XenoCube/ForeignBox/BOM.xlsx

Hardware
Quantity | Part | Description | Price | Link to Purchase
 | Exstrusion bar 20mm x 20mm | 15.99 for 6 ft | 32 | https://www.amazon.com/PDTech-T-slot-frame-aluminum-extrusion/dp/B071HBRBG8?s=industrial
2 | 8mm Lead Rod x 500mm x 2mm pitch W/ screw |  | 18.99 | https://www.amazon.com/GOCHANGE-Printer-Accessories-Stainless-Coupling/dp/B01GL4GYSK?s=industrial
1 | 8mm Lead Rod x 400mm x 2mm pitch W/ screw | 12.59 per one | 12.59 | https://www.amazon.com/Drillpro-400mm-Lead-Screw-Printer/dp/B017AR5QBS?s=industrial
8 | 8mm Drill Rod | 2 pack of 400mm length rods 18.50 per a pack. 4 rods will need to be 500mm for Z axis. | 80 | https://www.amazon.com/2-Pack-Linear-Motion-Length-Hardened/dp/B01I49ESN8?s=industrial
2 | M3 Socket Head Screw 20mm | 14.99 pack | 30 | https://www.amazon.com/Hilitchi-210pcs-Stainless-Socket-Assortment/dp/B014ONCP88?s=industrial
* | M3 Socket Head Screw 12mm | * | *
* | M3 Socket Head Screw | * | *
* | M3 Socket Head Screw | * | *
* | M3 Nut | * | *
100 | M5 Pan Socket Head Screw 10mm | 8.36 a pack | 17.24 | https://www.amazon.com/uxcell-Alloy-Socket-Button-Screws/dp/B019ETJWEC?s=industrial
100 | M5 Pan Socket Head Screw 8mm | 8.18 a pack of 50mm | 16.36 | https://www.amazon.com/uxcell-Alloy-Socket-Button-Screws/dp/B019ETJRME?s=industrial
3 | 608zz Bearings | 7.47 a pack of 8 | 7.47 | https://www.amazon.com/Skateboard-Bearings-Double-Shielded-Silver/dp/B002BBGTK6?s=industrial
1 | E3D V6 Hotend bowden 1.75mm | E3d V6 1.75mm Universal | 70.21 | https://www.amazon.com/E3D-All-metal-HotEnd-Full-Kit/dp/B00NAK9JFO?s=industrial
3 | Z Axis Couplers | 8.97 for a pack of 2 | 16 | https://www.amazon.com/3D-CAM-Flexible-Couplings-Printer/dp/B010MZ8T2S?s=industrial
1 | MK8 Extruder |  | 19.98 | https://www.amazon.com/Witbot-Printer-Extruder-Aluminum-Reprap/dp/B01KO42SBA?s=industrial
200 | M5 T Nut | This is the nut that works with the Exstrusion Bar. 18.99 for a pack of 100 | 37.98 | https://www.amazon.com/Economy-Pre-Assembly-T-Slot-Aluminum-Extrusions/dp/B018X8IRGY?s=industrial
15 | LM8UU Linear Bearings | 7.65 for 10 pack | 15 | https://www.amazon.com/uxcell-Bushing-Linear-Motion-Double/dp/B00X9H22SO
1 | Kapton Tape Sheet | 300mm x 300mm
5 | Plexiglass Sheet 18 in. x 24 in. x .080 in. (2mm)
1 | 3mm Foam Sheet
Electronics
Quantity | Part | Description | Price | Link to Purchase
6 | Nema Stepper Motors | Nema 17 Stepper Motors | 84 | https://www.amazon.com/Stepper-Bipolar-4-lead-Connector-Printer/dp/B00PNEQKC0
1 | MKS printer board | Osoyoo MKS Base V1.5 | 38.9 | https://www.amazon.com/OSOYOO-Controller-Combination-MEGA2560-RAMPS1-4/dp/B015SKY19M
1 | Raspberry Pi | Raspberry Pi 3 | 38.61 | https://www.amazon.com/Raspberry-Model-A1-2GHz-64-bit-quad-core/dp/B01CD5VC92?s=pc
1 | Mosfet Heatbed controller |  | 18 | https://www.reprap.me/electronics/power-expander.html
1 | 24v Power Supply | 24v x 600w Regulated Power Supply | 56.5 | https://www.amazon.com/Eyeboot-Universal-Regulated-Switching-Computer/dp/B018TH0DQG?s=electronics
1 | AC Plug W/ Switch W/ 10 amp Fuse | Power Cord connection w/ fuse /switch | 5.98 | https://www.amazon.com/URBEST-Module-Switch-Certification-Socket/dp/B00ME5YAPK?s=electronics
1 | 24v to 12v Power Inverter | 24v to 12v Power Inverter | 19.98 | https://www.amazon.com/Nextrox-Converter-Regulator-Step-Down/dp/B00BWKXTUU
2 | 8 Terminal Barrier Block | **4 terinmal block with insulated barrier strip | 10.8 | https://www.amazon.com/Position-Terminal-Postions-Insulated-Barrier/dp/B01AQ94ERY?s=electronics
1 | 12v to 5v Power Inverter | 12v to 5v | 6.99 | https://www.amazon.com/SMAKN-Converter-Power-Supply-Module/dp/B00CXKBJI2?s=electronics
4 | Optic Endstop Sensors | Optical EndStops | 8.99 | https://www.amazon.com/BIQU-Optical-Endstop-Control-Printer/dp/B01FLSA47O?s=industrial
2 | 40mm x 40mm x 10mm Fan 12v | 40mm Case Fan | 15.68 | https://www.amazon.com/2packs-0-15A-Brushless-Cooling-AB4010M12/dp/B01CZFUOD0?s=industrial
1 | Inductive Sensor | 4mm inductive sensor for bed leveling | 7.89 | https://www.amazon.com/uxcell-DC6-36V-Inductive-Proximity-LJ12A3-4-Z-BX/dp/B008DG9FLS?s=industrial
1 | 300mm x 300mm MKS Heatbed | 300mm heatbed | 30.99 | https://www.amazon.com/TriGorilla-Printer-Aluminum-Heatbed-Supply/dp/B01KJJYIPE?s=industrial
1 | Thermistor | Only one is needed but pack of three listed | 7.5 | https://www.amazon.com/3D-CAM-Thermistors-pre-wired-Insulated/dp/B010MZ8TCS?s=industrial
 | 14 gauge Wire Red | pack of red and black | 21.95 | https://www.amazon.com/ENNIS-ELECTRONICS-PRIMARY-REMOTE-COPPER/dp/B06XCTWPMM?s=industrial
 | 14 gauge Wire Black | * | * | *
 | 12 guage Wire Black | Pack of red and black | 13.97 | https://www.amazon.com/GAUGE-GROUND-PRIMARY-STRANDED-COPPER/dp/B01AO1K5HW?s=industrial
 | 12 gauge Wire Red | * | * | *
 | 18 gauge Wire Red | Single Spool | 8.98 | https://www.amazon.com/Southwire-55667423-Primary-18-Gauge-100-Feet/dp/B000HACYOS?s=industrial
 | 18 gauge Wire Black | Single spool |  | https://www.amazon.com/Southwire-55667423-Primary-18-Gauge-100-Feet/dp/B000HACYOS?s=industrial
 | Heat Shrink | Assorted | 6.95 | https://www.amazon.com/Anytime-Tools-AT201262-Shrink-Assorted/dp/B008WWC6FU?s=industrial
 | 12-10 gauge Quick Disconnects | Assorted | 15.99 | https://www.amazon.com/Glarks-Disconnect-Electrical-Connectors-Assortment/dp/B01E3TGECG?s=industrial
 | 14-16 gauge Spade or Ring Wire Connectors | *
 | 2x40 Pin 2,54 Pitch - Header Pins
 |  |  | 792.47
