XenoCube/ForeignBox/(list of files, cad)

Other CAD files:
XC Sketchup/12to5v Inverter and Heatbed Relay Mount.skp
XC Sketchup/24vTo12 Inverter Mount.skp
XC Sketchup/8mm Threaded Rod Stay.skp
XC Sketchup/90 Wire Clamp.skp
XC Sketchup/Cam Mount.skp
XC Sketchup/Door Handle.skp
XC Sketchup/Door Hinge.skp
XC Sketchup/Filament Spool Holder.skp
XC Sketchup/Frame Corner Foot Bracket.skp
XC Sketchup/Frame T Bracket.skp
XC Sketchup/Heatbead Wire Holder.skp
XC Sketchup/Heatbed Plate Mount.skp
XC Sketchup/HotEnd Ducting.skp
XC Sketchup/Hotend Ducting Back.skp
XC Sketchup/Hotend Ducting Fan Mount.skp
XC Sketchup/Hotend Ducting Upper.skp
XC Sketchup/LED Light Clamp.skp
XC Sketchup/MKS Controller Board Mount Leftside.skp
XC Sketchup/MKS Controller Board Mount Rightside.skp
XC Sketchup/Power Supply Mount Left.skp
XC Sketchup/Power Supply Mount Right.skp
XC Sketchup/Power Switch Mount.skp
XC Sketchup/Raspberry Pi Mount.skp
XC Sketchup/Tension Spring Cap Extruder.skp
XC Sketchup/Terminal Block Bracket.skp
XC Sketchup/Top Corner Cover Plate.skp
XC Sketchup/Top Middle Cover Plate.skp
XC Sketchup/Top Slider Corner with Wiring.skp
XC Sketchup/Wire Clamp 6mm Hole Ziptie.skp
XC Sketchup/Wire Clamp 90 Outside.skp
XC Sketchup/X Axis Carriage.skp
XC Sketchup/X Axis Endstop.skp
XC Sketchup/X Axis Idler V5.skp
XC Sketchup/X Axis Motor Mount v3.skp
XC Sketchup/XY Endstop v3.skp
XC Sketchup/Y Axis End Stop.skp
XC Sketchup/Y Axis Motor Mount v2.skp
XC Sketchup/Y Axis Motor Mount.skp
XC Sketchup/Y Axis Smooth Rod Bracket.skp
XC Sketchup/Y Axis Wire Holder.skp
XC Sketchup/Z Axis Bed Mount.skp
XC Sketchup/Z Axis Endstop Adjustable Inductive Bed Level.skp
XC Sketchup/Z Axis Motor Mount.skp
XC Sketchup/Z Endstop.skp
XC Sketchup/Z-Axis idler v5.skp
