XenoCube/ForeignBox/Power Wiring Diagram.jpg

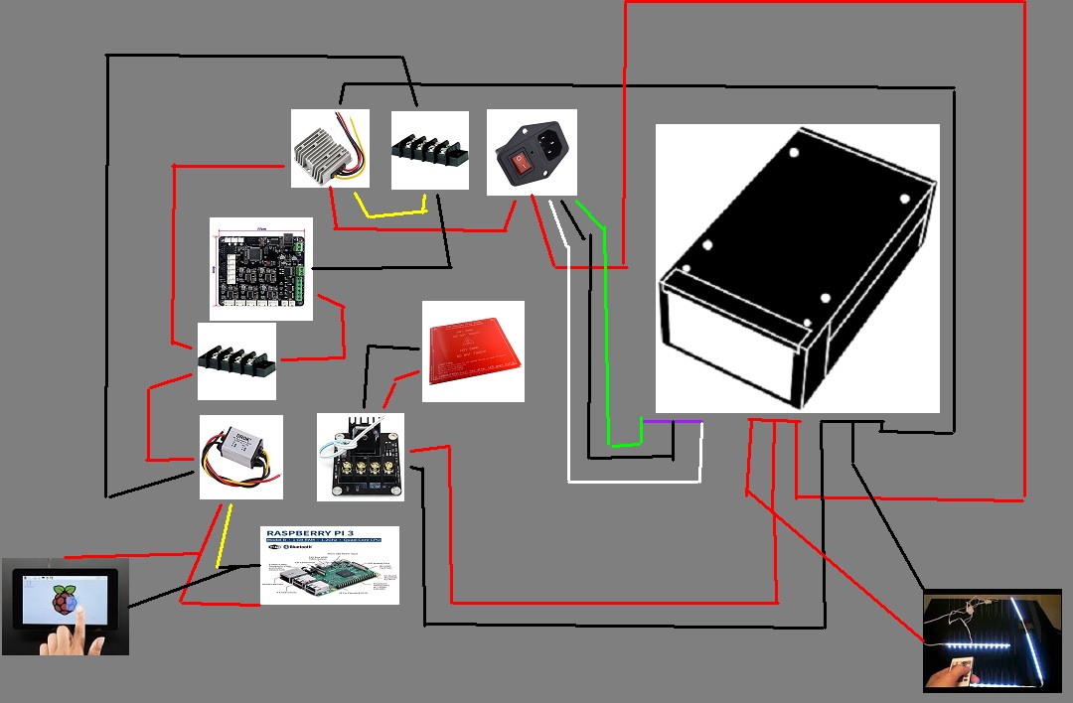
Power Wiring Diagram.jpg
